mandryd/Flatbox/flatbox_mods/readme.md

Long's Flatbox Mods
-----------------
Note, these are modifications of [Jfedor's Flatbox](https://github.com/jfedor2/flatbox).  All credit goes to him for making an awesome design.  

<table width=100%>
<TR>
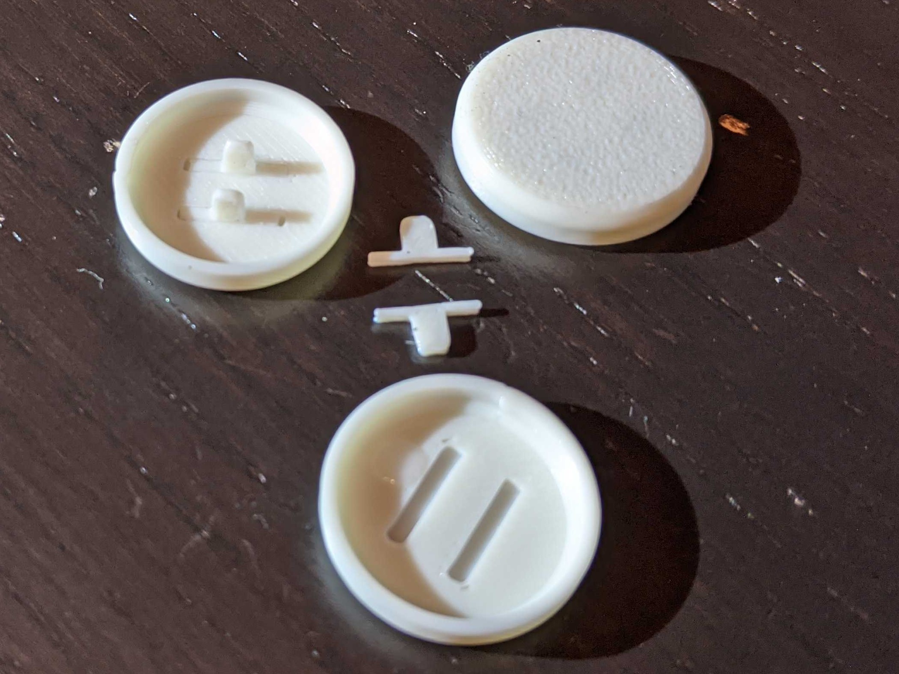
[picture p1: flatbox_mods/Buttons/images/buttons.jpg]
<TD width=50% align="center"></TD>
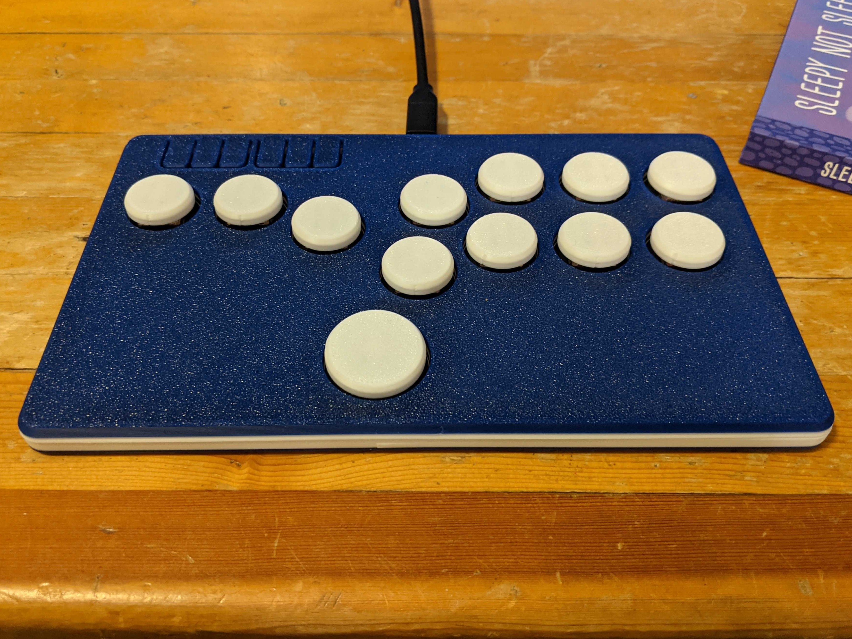
[picture p2: flatbox_mods/Rev4Case/images/assembled.jpg]
<TD width=50% align="center"></TD>
</TR>
<TR>
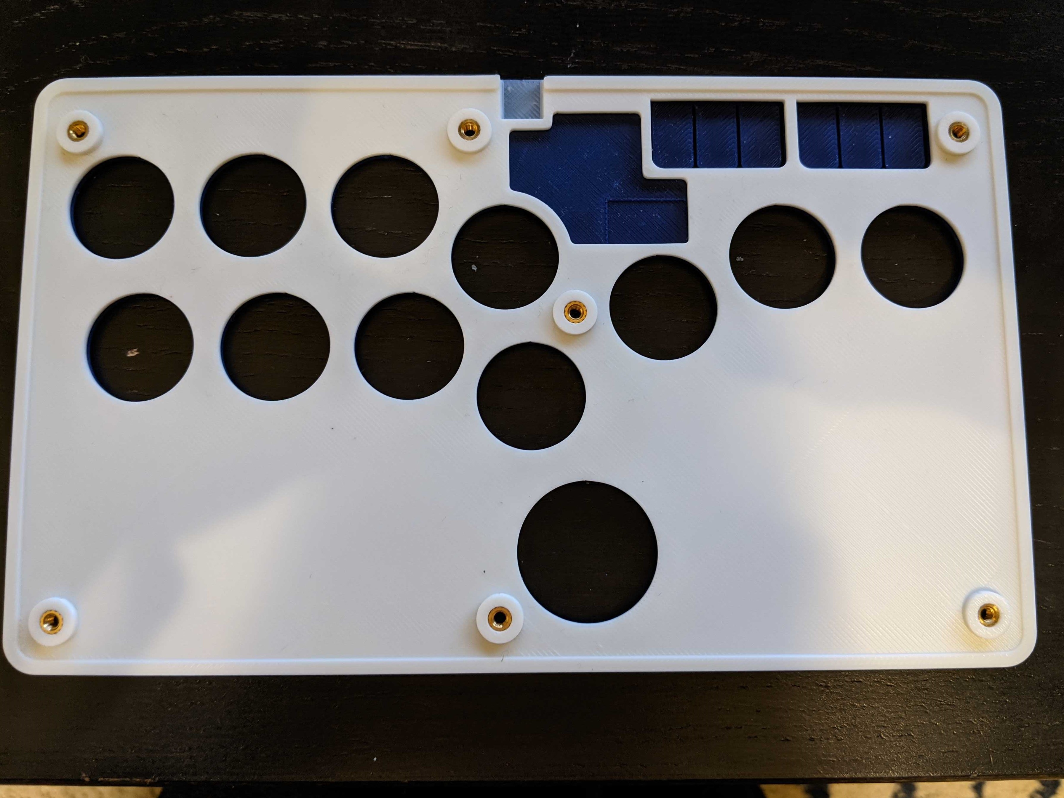
[picture p3: flatbox_mods/Rev4Case/images/inside_top.jpg]
<TD width=50% align="center"></TD>
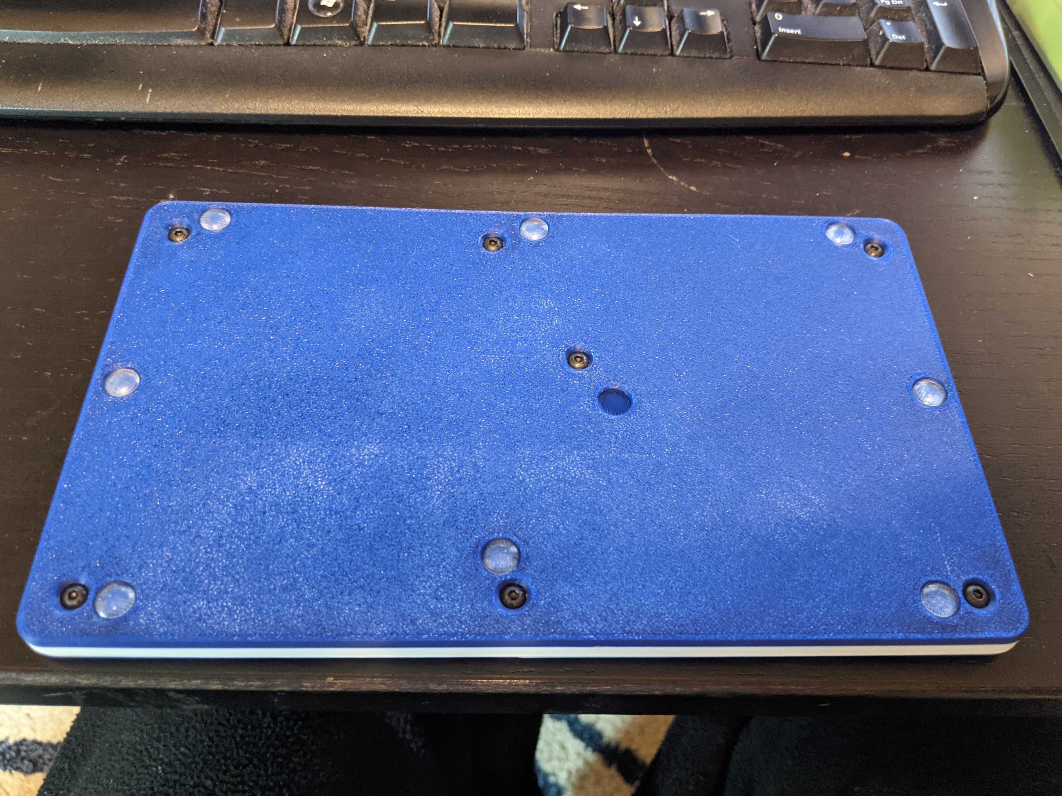
[picture p4: flatbox_mods/Rev4Case/images/rear.jpg]
<TD width=50% align="center"></TD>
</TR>
</TABLE>

 - [Buttons](Buttons/)
   - I frequently see single piece 3d printed button caps.  The issues with printing button caps as a single piece is that the legs are printed in a weak orientation and break off very easily.  
   - This design separates the legs from the button caps so that the legs are now printed in the strongest orientation and are much less likely to break.  Once you glue the legs into the caps, they will feel very strong.
 - [Rev 4 Case with Heatsets](Rev4Case/)
   - Case modified to use brass heatsets and m3 screws instead of wood screws.  I prefer using brass threaded heatsets instead of screwing into plastic if possible.
   - Also makes some small changes to the appearance of the face buttons.
