mandryd/Flatbox/flatbox_mods/Buttons/loose_tolerance__cap_24mm_v1.0.stl

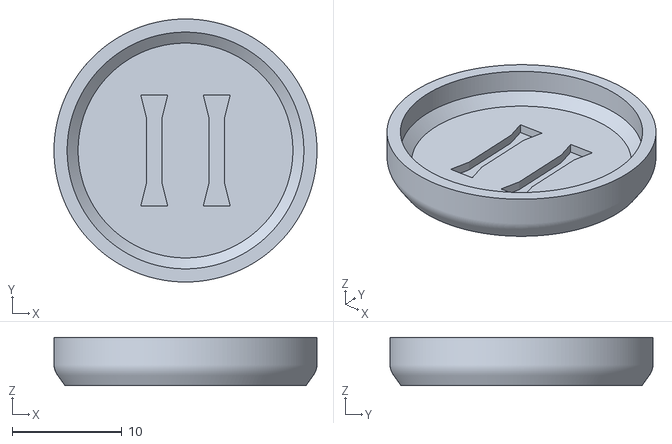
[picture p6: CAD file, 2022-10-28]
flatbox_mods/Buttons/loose_tolerance__cap_24mm_v1.0.stl
24.0 x 24.0 x 4.40
