mandryd/Flatbox/flatbox_mods/Rev4Case/rev4_lower_hotswap_heatsets.stl

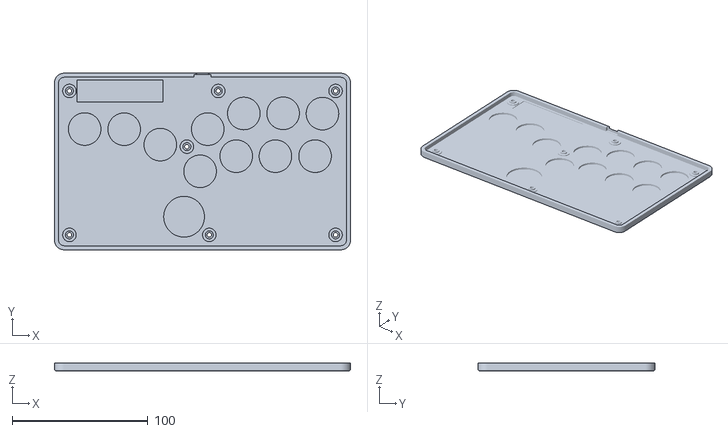
[picture p7: CAD file, 2022-02-20]
flatbox_mods/Rev4Case/rev4_lower_hotswap_heatsets.stl
218.0 x 130.1 x 6.20
