mandryd/Flatbox/flatbox_mods/Rev4Case/rev4_upper.stl

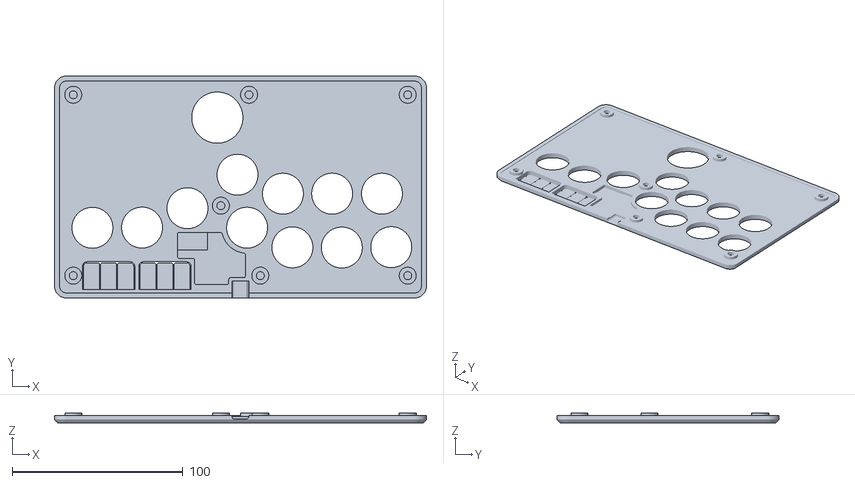
[picture p8: CAD file, 2022-02-20]
flatbox_mods/Rev4Case/rev4_upper.stl
218.0 x 130.1 x 6.00
