mandryd/Flatbox/flatbox_mods/Buttons/loose_tolerance__cap_28.5mm_v1.0.stl

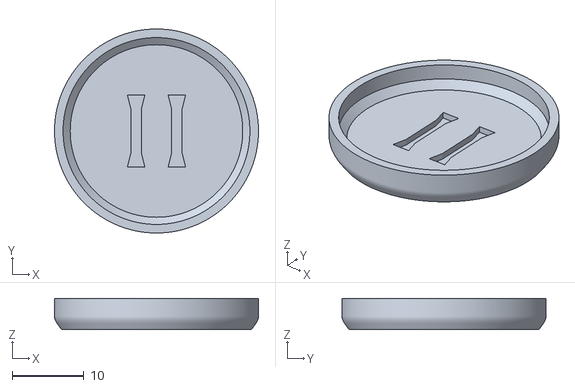
[picture p9: CAD file, 2022-02-20]
flatbox_mods/Buttons/loose_tolerance__cap_28.5mm_v1.0.stl
28.5 x 28.5 x 4.40
