mandryd/Flatbox/flatbox_mods/Rev4Case/rev4_case_hotswap_heatsets_v1.0.step

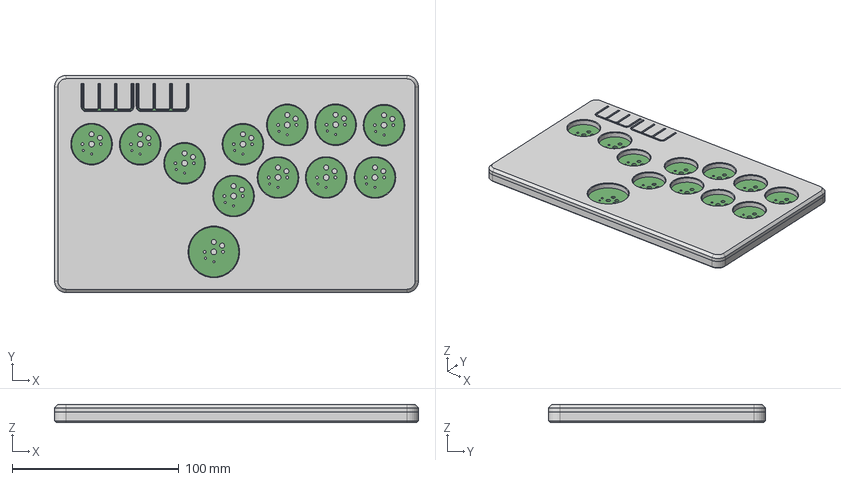
[picture p10: CAD file, 2022-02-20]
flatbox_mods/Rev4Case/rev4_case_hotswap_heatsets_v1.0.step
218.0 x 130.1 x 10.8 mm
Board and PCB Pic
