mandryd/Flatbox/flatbox_mods/Buttons/loose_tolerance__cap_22.5mm_v1.0.stl

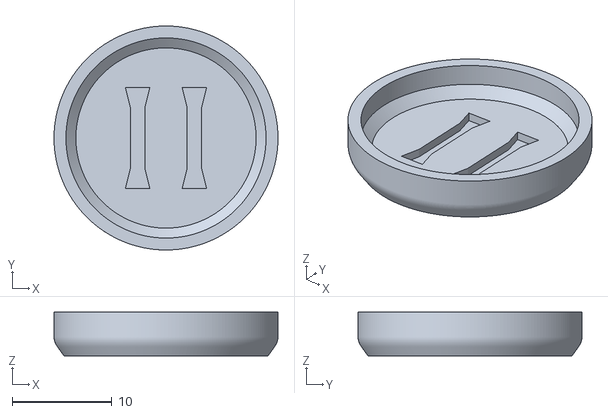
[picture p11: CAD file, 2022-02-20]
flatbox_mods/Buttons/loose_tolerance__cap_22.5mm_v1.0.stl
22.5 x 22.5 x 4.40
