mandryd/Flatbox/flatbox_mods/Buttons/tight_tolerance_leg_v1.0.stl

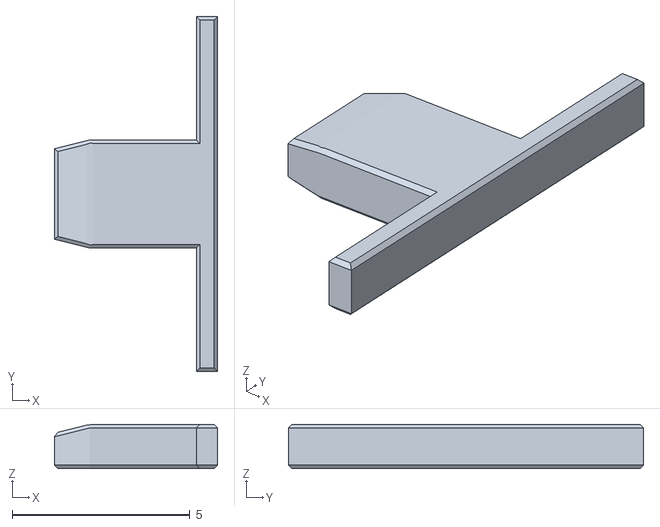
[picture p12: CAD file, 2022-02-20]
flatbox_mods/Buttons/tight_tolerance_leg_v1.0.stl
4.60 x 10.0 x 1.25
