mandryd/Flatbox/flatbox_mods/Buttons/loose_tolerance_leg_v1.0.stl

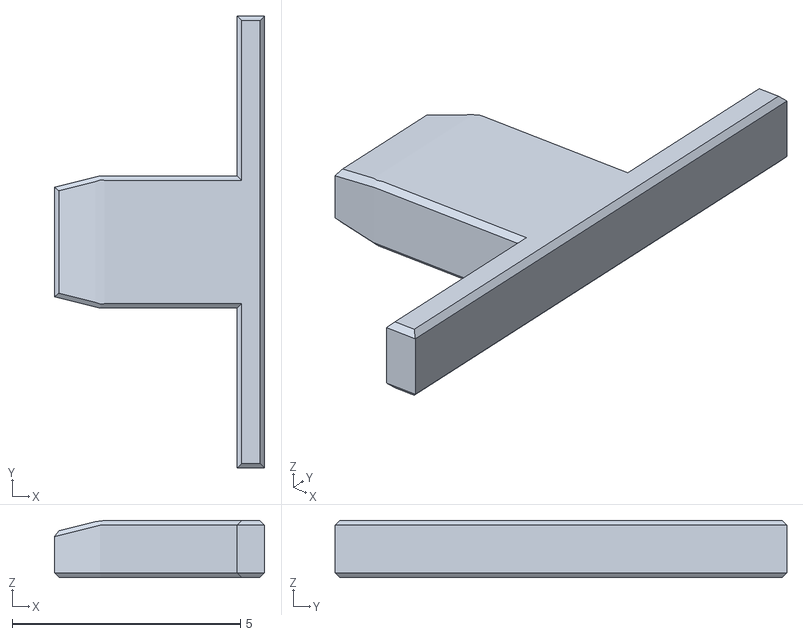
[picture p13: CAD file, 2022-02-20]
flatbox_mods/Buttons/loose_tolerance_leg_v1.0.stl
4.60 x 9.90 x 1.25
