mandryd/Flatbox/flatbox_mods/Buttons/Choc_v1_Buttons.step

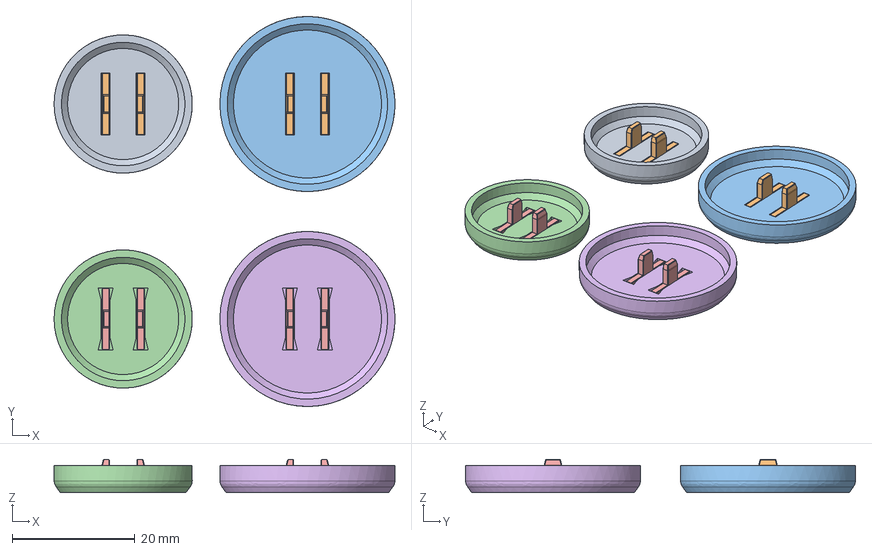
[picture p14: CAD file, 2022-02-20]
flatbox_mods/Buttons/Choc_v1_Buttons.step
55.5 x 63.5 x 5.40 mm
22.5mm Tight Fit
28.5mm tight fit
22.5mm Loose Fit
22.5mm Loose Fit (1)
