mandryd/Flatbox/(list of files, cad)

Other CAD files:
flatbox_mods/Buttons/tight_tolerance__cap_24mm_v1.0.stl
flatbox_mods/Buttons/tight_tolerance__cap_22.5mm_v1.0.stl
flatbox_mods/Buttons/tight_tolerance__cap_28.5mm_v1.0.stl
